JorgeMarcano/PSU_Front_End/PSU_Front_End/PSU_Front_End.kicad_pcb

## KiCad design PSU_Front_End/PSU_Front_End.kicad_pcb (2024-05-07)

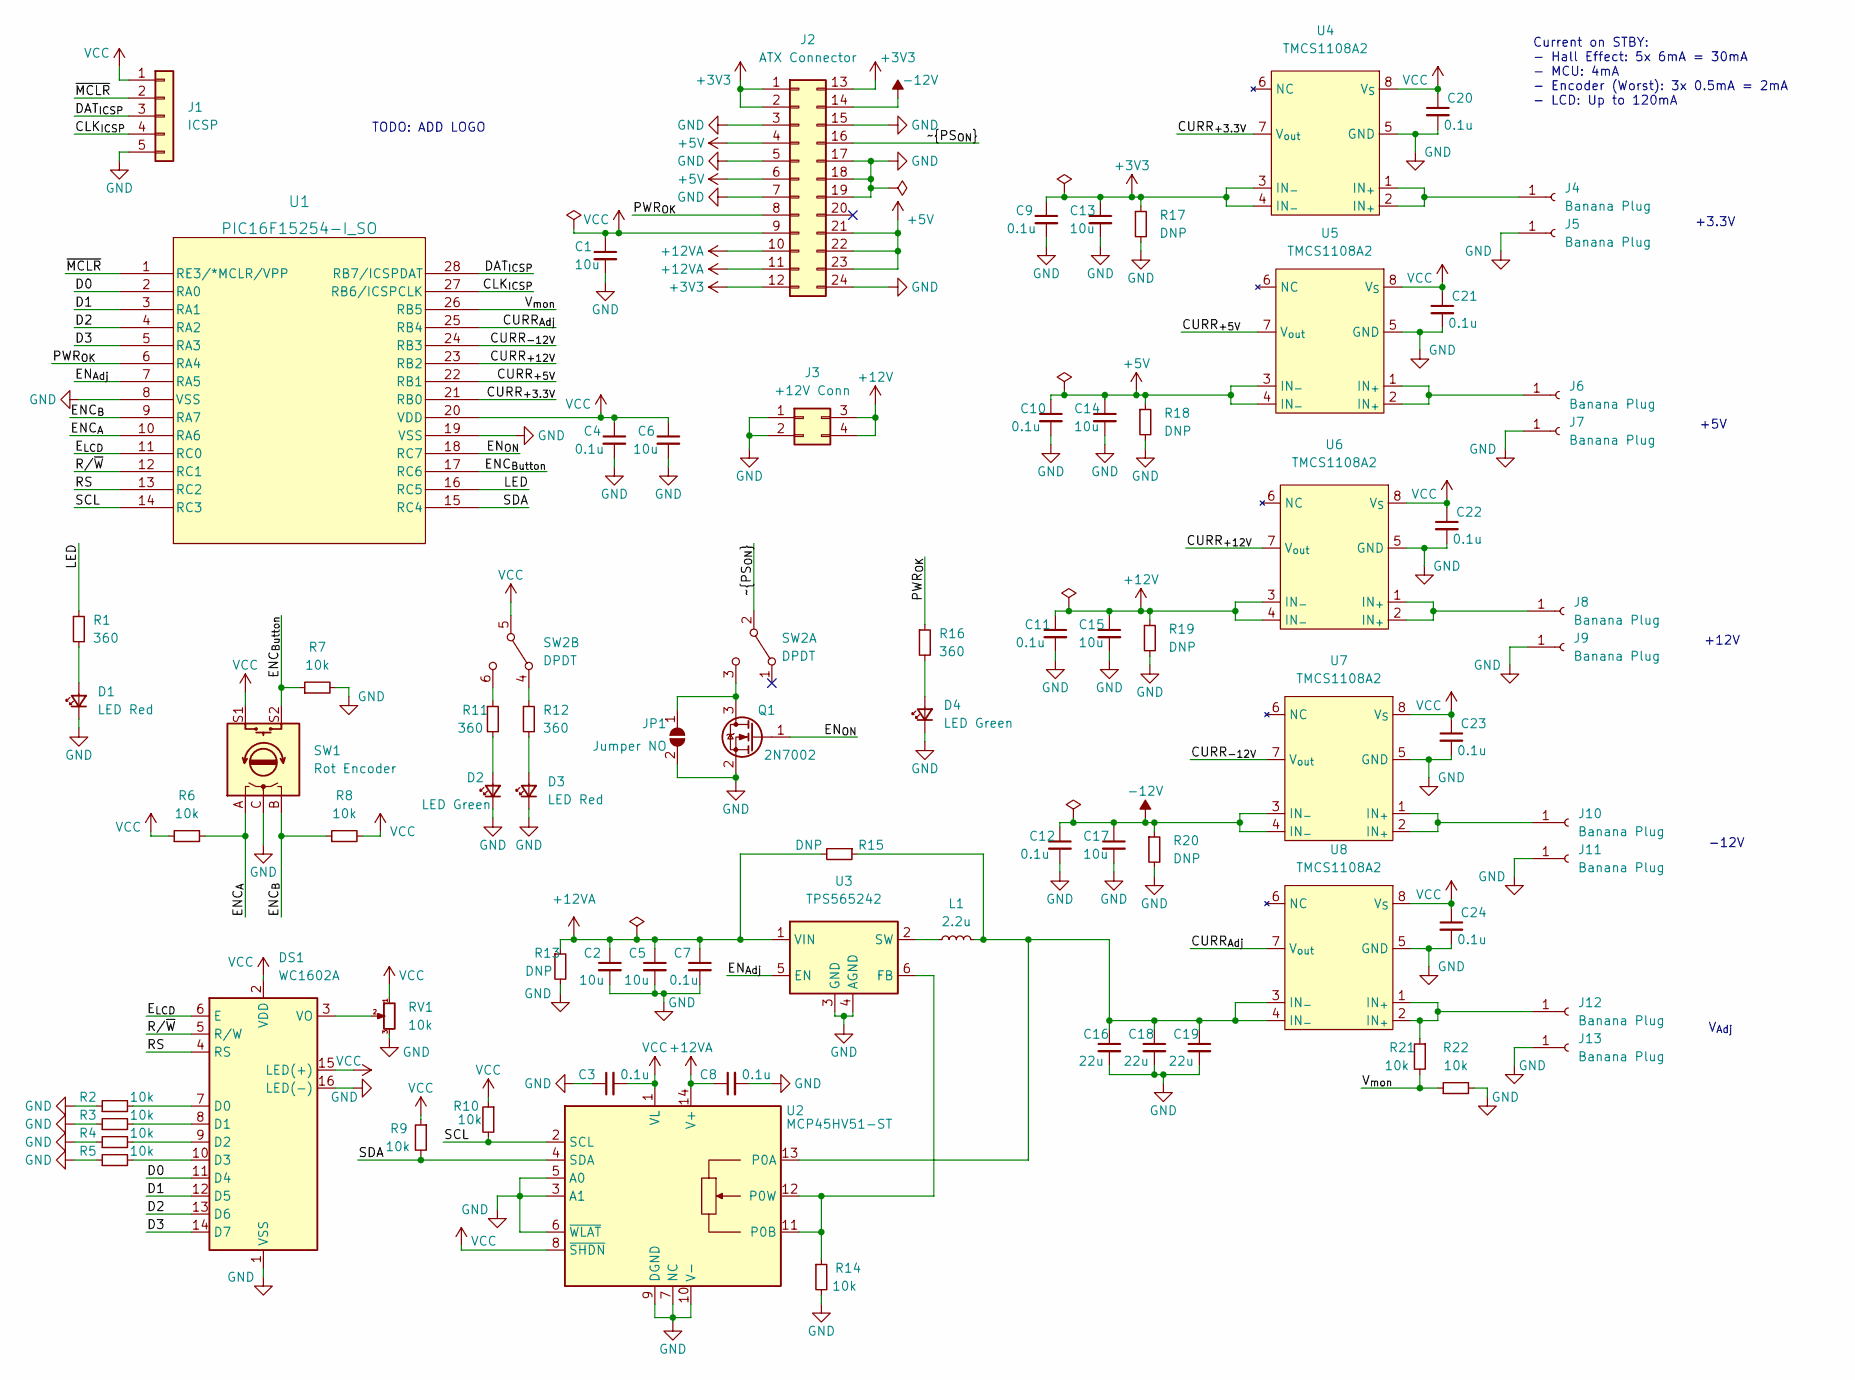
[picture p1: schematic PSU_Front_End.kicad_sch]

Parts:
C1, C2, C5, C6, C13, C14, C15, C17: 10u; C_0805_2012Metric_Pad1.18x1.45mm_HandSolder; MFG PN 1276-2891-1-ND
C3, C4, C7, C8, C9, C10, C11, C12, C20, C21, C22, C23, C24: 0.1u; C_0805_2012Metric_Pad1.18x1.45mm_HandSolder; MFG PN 1276-1099-1-ND
C16, C18, C19: 22u; C_0805_2012Metric_Pad1.18x1.45mm_HandSolder; MFG PN 1276-CL21A226MAYNNNECT-ND
D1, D3: LED Red; LED_0603_1608Metric_Pad1.05x0.95mm_HandSolder; MFG PN 3147-B1931USD-20D000814U1930CT-ND
D2, D4: LED Green; LED_0603_1608Metric_Pad1.05x0.95mm_HandSolder; MFG PN 3147-B1931NG--20D001114U1930CT-ND
DS1: WC1602A; MFG PN 4411-CN0293-ND
J1: ICSP; PinHeader_1x05_P2.54mm_Vertical
J2: ATX Connector; Molex_Mini-Fit_Jr_5566-24A2_2x12_P4.20mm_Vertical; MFG PN 23-0039299247-ND
J3: +12V Conn; Molex_Mini-Fit_Jr_5566-04A2_2x02_P4.20mm_Vertical; MFG PN WM7325-ND
J4, J5, J6, J7, J8, J9, J10, J11, J12, J13: Banana Plug; Banana_Jack_1Pin
JP1: Jumper NO; SolderJumper-2_P1.3mm_Open_RoundedPad1.0x1.5mm
L1: 2.2u; L_Abracon_ASPI-0630LR; MFG PN 553-BMRA000606302R2MA1CT-ND
Q1: 2N7002; SOT-23; MFG PN 1727-8643-1-ND
R1, R11, R12, R16: 360; R_0805_2012Metric_Pad1.20x1.40mm_HandSolder; MFG PN 738-RMCF0805FT360RCT-ND
R2, R3, R4, R5, R6, R7, R8, R9, R10, R14, R21, R22: 10k; R_0805_2012Metric_Pad1.20x1.40mm_HandSolder; MFG PN RMCF0805FT10K0CT-ND
R13, R15, R17, R18, R19, R20: DNP; R_Axial_DIN0309_L9.0mm_D3.2mm_P12.70mm_Horizontal
RV1: 10k; TrimPot; MFG PN 119-06TR4DA103CP-ND
SW1: Rot Encoder; RotaryEncoder_Alps_EC12E-Switch_Vertical_H20mm; MFG PN PEC12R-4130F-S0012-ND
SW2: DPDT; SW DPDT; MFG PN 2449-ANT21SECQE-ND
U1: PIC16F15254-I_SO; SOIC-28W_7.5x18.7mm_P1.27mm; MFG PN 150-PIC16F15254-I/SO-ND
U2: MCP45HV51-ST; TSSOP-14_4.4x5mm_P0.65mm; MFG PN MCP45HV51-104E/ST-ND
U3: TPS565242; SOT-563; MFG PN 296-TPS565242DRLRCT-ND
U4, U5, U6, U7, U8: TMCS1108A2; SOIC-8-Wider; MFG PN 296-TMCS1108A2BQDTCT-ND

Connections:
+3V3: C9.1, C13.1, J2.1, J2.2, J2.12, J2.13, R17.1, U4.3 (IN_{-}), U4.4 (IN_{-})
+5V: C10.1, C14.1, J2.4, J2.6, J2.21, J2.22, J2.23, R18.1, U5.3 (IN_{-}), U5.4 (IN_{-})
+12V: C11.1, C15.1, J3.3, J3.4, R19.1, U6.3 (IN_{-}), U6.4 (IN_{-})
+12VA: C2.1, C5.1, C7.1, C8.1, J2.10, J2.11, R13.1, R15.2, U2.14 (V+), U3.1 (VIN)
-12V: C12.1, C17.1, J2.14, R20.1, U7.3 (IN_{-}), U7.4 (IN_{-})
/CLK_{ICSP}: J1.4, U1.27 (RB6/ICSPCLK)
/CURR_{+3.3V}: U1.21 (RB0), U4.7 (V_{out})
/CURR_{+5V}: U1.22 (RB1), U5.7 (V_{out})
/CURR_{+12V}: U1.23 (RB2), U6.7 (V_{out})
/CURR_{-12V}: U1.24 (RB3), U7.7 (V_{out})
/CURR_{Adj}: U1.25 (RB4), U8.7 (V_{out})
/D0: DS1.11 (D4), U1.2 (RA0)
/D1: DS1.12 (D5), U1.3 (RA1)
/D2: DS1.13 (D6), U1.4 (RA2)
/D3: DS1.14 (D7), U1.5 (RA3)
/DAT_{ICSP}: J1.3, U1.28 (RB7/ICSPDAT)
/ENC_{A}: R6.2, SW1.A, U1.10 (RA6)
/ENC_{Button}: R7.1, SW1.S2, U1.17 (RC6)
/ENC_{B}: R8.1, SW1.B, U1.9 (RA7)
/EN_{Adj}: U1.7 (RA5), U3.5 (EN)
/EN_{ON}: Q1.1 (G), U1.18 (RC7)
/E_{LCD}: DS1.6 (E), U1.11 (RC0)
/LED: R1.1, U1.16 (RC5)
/PWR_{OK}: J2.8, R16.1, U1.6 (RA4)
/RS: DS1.4 (RS), U1.13 (RC2)
/R/~W: DS1.5 (R/W), U1.12 (RC1)
/SCL: R10.2, U1.14 (RC3), U2.2 (SCL)
/SDA: R9.2, U1.15 (RC4), U2.4 (SDA)
/V_{mon}: R21.2, R22.1, U1.26 (RB5)
/~MCLR: J1.2, U1.1 (RE3/*MCLR/VPP)
/~PS_{ON}: J2.16, SW2.2 (B)
GND: C1.2, C2.2, C3.1, C4.2, C5.2, C6.2, C7.2, C8.2, C9.2, C10.2, C11.2, C12.2, C13.2, C14.2, C15.2, C16.2, C17.2, C18.2, C19.2, C20.2, C21.2, C22.2, C23.2, C24.2, D1.1 (K), D2.1 (K), D3.1 (K), D4.1 (K), DS1.1 (VSS), DS1.16 (LED(-)), J1.5, J2.3, J2.5, J2.7, J2.15, J2.17, J2.18, J2.19, J2.24, J3.1, J3.2, J5.1, J7.1, J9.1, J11.1, J13.1, JP1.2 (B), Q1.2 (S), R2.1, R3.1, R4.1, R5.1, R7.2, R13.2, R14.2, R17.2, R18.2, R19.2, R20.2, R22.2, RV1.3, SW1.C, U1.8 (VSS), U1.19 (VSS), U2.3 (A1), U2.5 (A0), U2.6 (~WLAT), U2.7 (NC), U2.9 (DGND), U2.10 (V-), U3.3 (GND), U3.4 (AGND), U4.5 (GND), U5.5 (GND), U6.5 (GND), U7.5 (GND), U8.5 (GND)
unnamed: C16.1, C18.1, C19.1, L1.2, R15.1, U2.13 (P0A), U8.3 (IN_{-}), U8.4 (IN_{-})
unnamed: D1.2 (A), R1.2
unnamed: D2.2 (A), R11.2
unnamed: D3.2 (A), R12.2
unnamed: D4.2 (A), R16.2
unnamed: DS1.3 (VO), RV1.2
unnamed: DS1.7 (D0), R2.2
unnamed: DS1.8 (D1), R3.2
unnamed: DS1.9 (D2), R4.2
unnamed: DS1.10 (D3), R5.2
unnamed: J4.1, U4.1 (IN_{+}), U4.2 (IN_{+})
unnamed: J6.1, U5.1 (IN_{+}), U5.2 (IN_{+})
unnamed: J8.1, U6.1 (IN_{+}), U6.2 (IN_{+})
unnamed: J10.1, U7.1 (IN_{+}), U7.2 (IN_{+})
unnamed: J12.1, R21.1, U8.1 (IN_{+}), U8.2 (IN_{+})
unnamed: JP1.1 (A), Q1.3 (D), SW2.3 (C)
unnamed: L1.1, U3.2 (SW)
unnamed: R11.1, SW2.6 (C)
unnamed: R12.1, SW2.4 (A)
unnamed: R14.1, U2.11 (P0B), U2.12 (P0W), U3.6 (FB)
VCC: C1.1, C3.2, C4.1, C6.1, C20.1, C21.1, C22.1, C23.1, C24.1, DS1.2 (VDD), DS1.15 (LED(+)), J1.1, J2.9, R6.1, R8.2, R9.1, R10.1, RV1.1, SW1.S1, SW2.5 (B), U1.20 (VDD), U2.1 (VL), U2.8 (~SHDN), U4.8 (V_{S}), U5.8 (V_{S}), U6.8 (V_{S}), U7.8 (V_{S}), U8.8 (V_{S})

Notes on the sheet:
+12V
-12V
+3.3V
TODO: ADD LOGO
V_{Adj}
Current on STBY: - Hall Effect: 5x 6mA = 30mA - MCU: 4mA - Encoder (Worst): 3x 0.5mA = 2mA - LCD: Up to 120mA
+5V

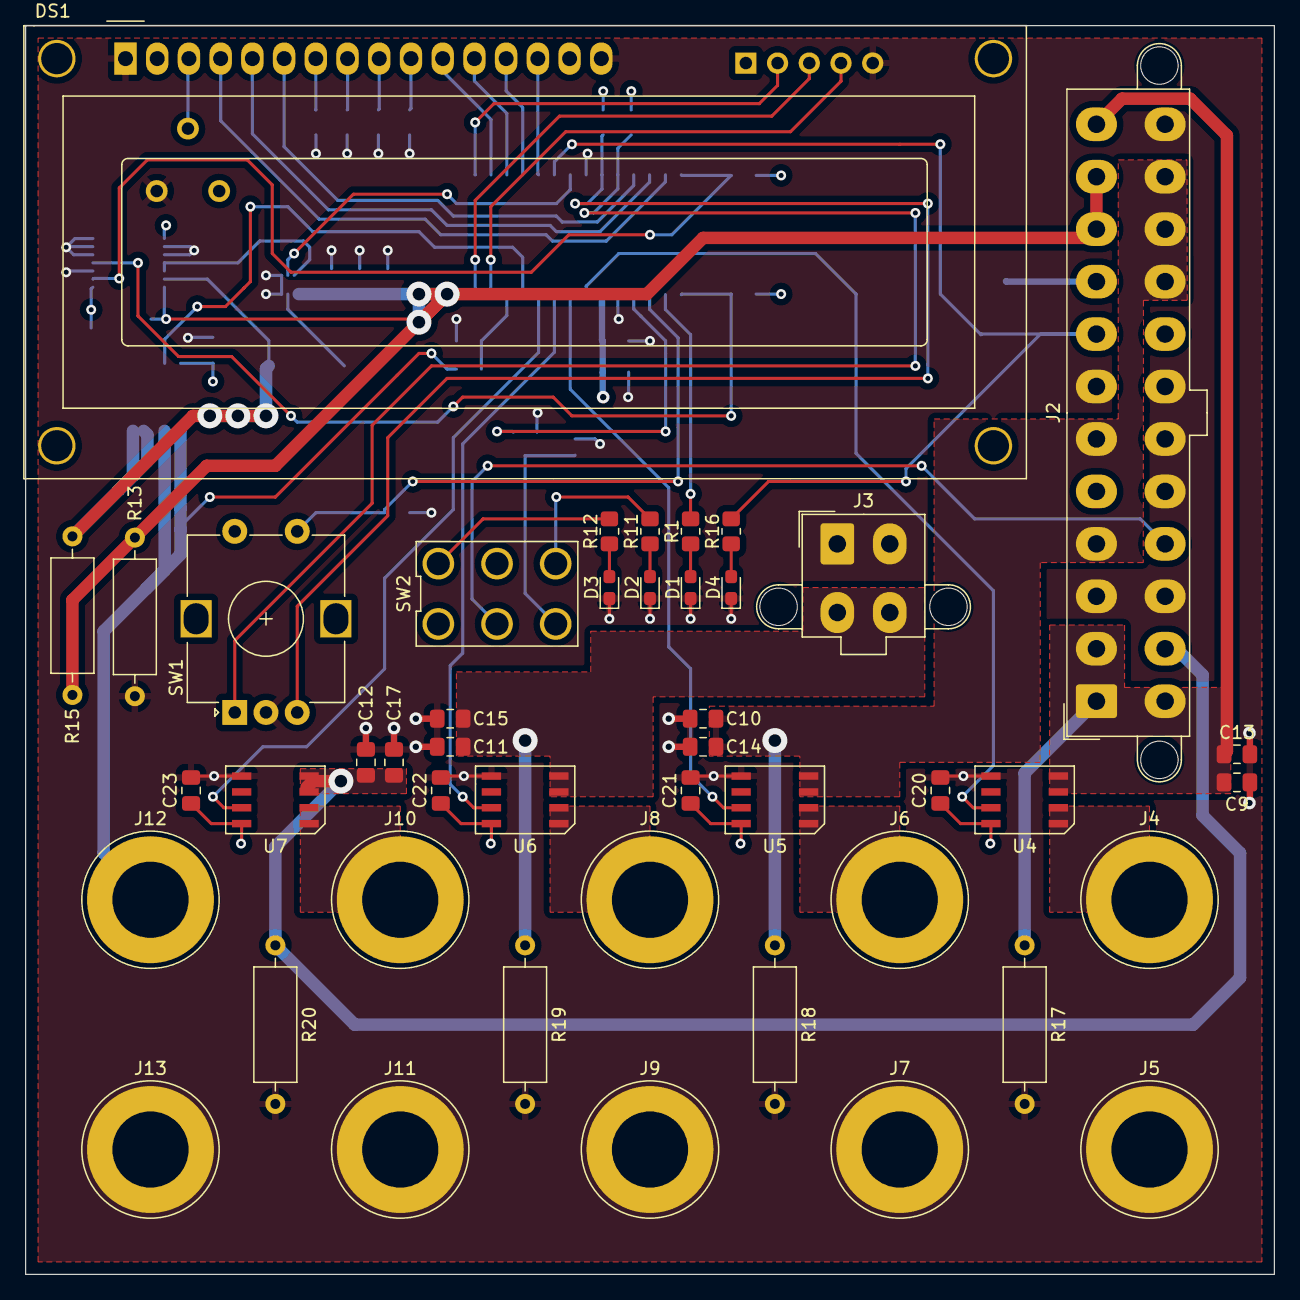
[picture p2: board PSU_Front_End.kicad_pcb from above]

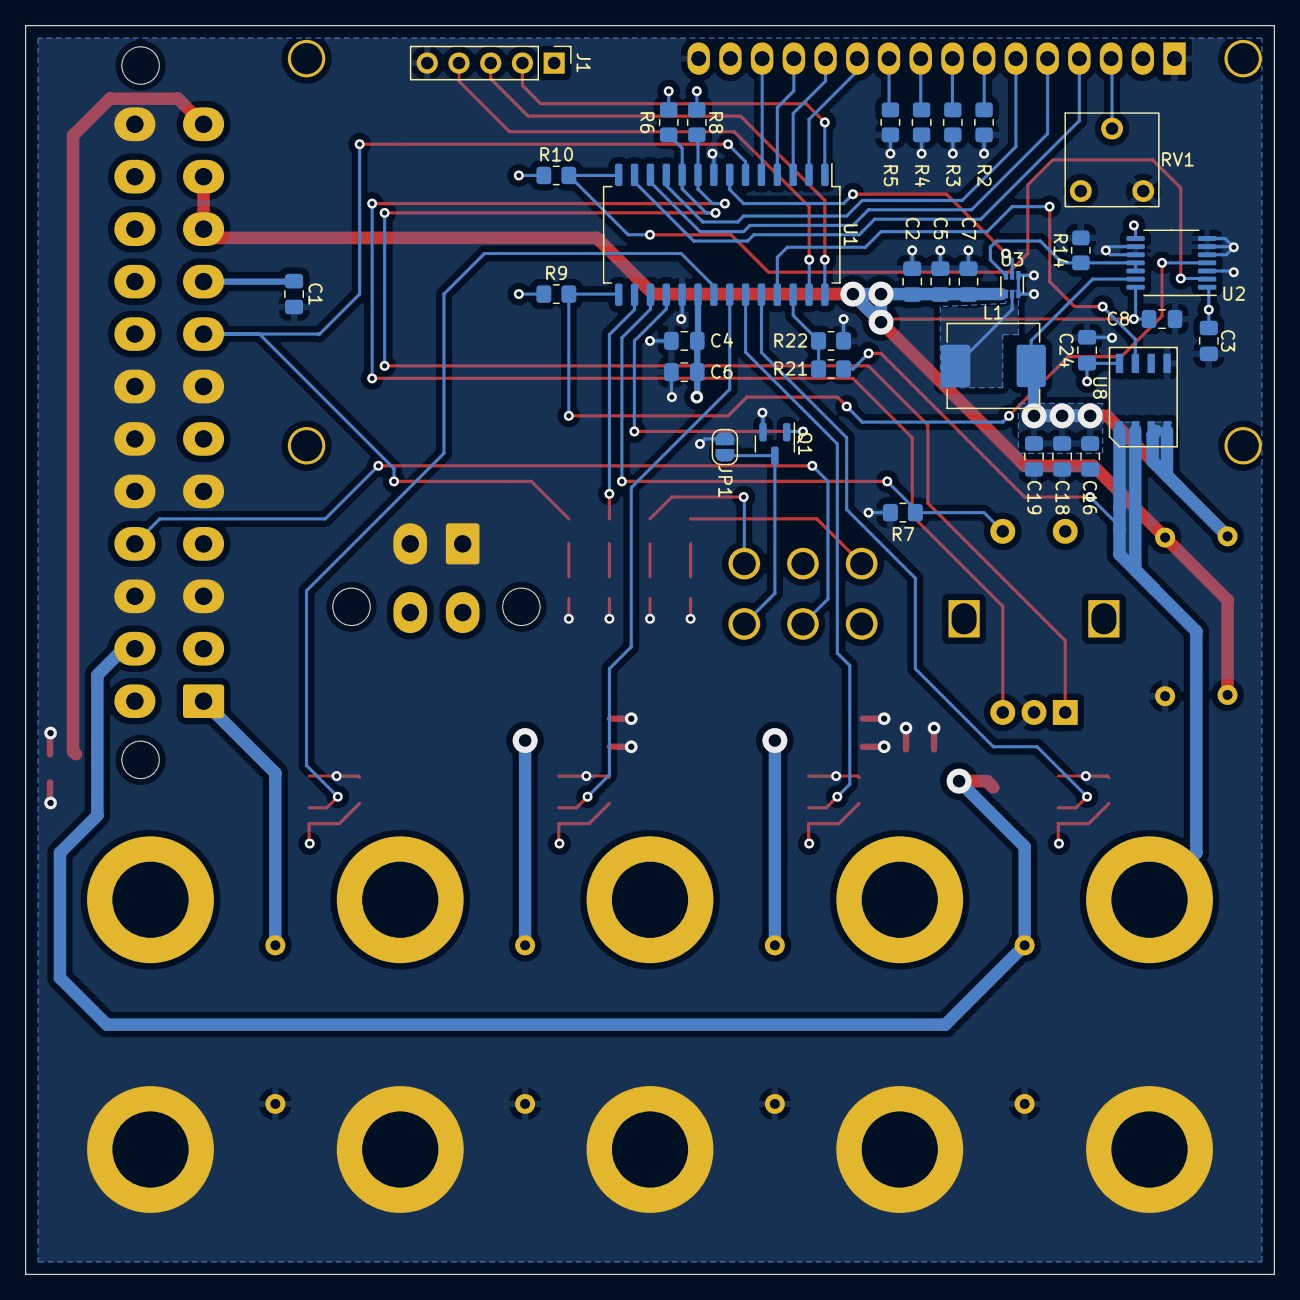
[picture p3: board PSU_Front_End.kicad_pcb from below]

Board: 4 copper layers, 100.0 x 100.0 mm, 78 parts (33 on the bottom side), 53 nets.
