JorgeMarcano/PSU_Front_End/(commit log)

2024-05-03 Schematic Done
    Schematic Done and almost done BOM
    [PSU_Front_End.kicad_pcb, PSU_Front_End.kicad_sch]
2024-05-07 Finished Board Layout
    [PSU_Front_End.kicad_pcb, PSU_Front_End.kicad_sch]
